willson556/OpenFFBoard-hardware/G27_InterfaceBoard/G27-Build-BOM.ods

Sheet: Summary
Description | Cost
Digikey (mostly PCB components) | $154.33
Large Components | $476.01
PCBs from JLCPCB | $96.12
Total | $726.46

Sheet: Digikey
Quantity Required | Quantity Ordered | Part Number | Manufacturer Part Number | Description | Board | Customer Reference | Backorder | Unit Price | Extended Price
1 | 2 | 732-4980-1-ND | 150060VS75000 | LED GREEN CLEAR 0603 SMD | TMC | 2 | 0 | 0.14 | $0.28
1 | 2 | 497-17239-1-ND | LDL1117S33R | IC REG LINEAR 3.3V 1.2A SOT223 | TMC | 10 | 0 | 0.48 | $0.96
12 | 15 | RMCF0603FT1K50CT-ND | RMCF0603FT1K50 | RES 1.5K OHM 1% 1/10W 0603 | TMC | 11 | 0 | 0.015 | $0.23
2 | 4 | 696-1184-1-ND | CSR2512C0R0015F | RES 0.0015 OHM 1% 3W 2512 | TMC | 12 | 0 | 0.65 | $2.60
17 | 20 | 1276-1000-1-ND | CL10B104KB8NNNC | CAP CER 0.1UF 50V X7R 0603 | TMC | 13 | 0 | 0.029 | $0.58
5 | 10 | 1276-6840-1-ND | CL21B104KCFNNNE | CAP CER 0.1UF 100V X7R 0805 | TMC | 14 | 0 | 0.054 | $0.54
3 | 10 | 720-VJ0603Y101KXAPW1BCCT-ND | VJ0603Y101KXAPW1BC | CAP CER 100PF 50V X7R 0603 | TMC | 15 | 0 | 0.074 | $0.74
10 | 16 | 311-10.0KHRCT-ND | RC0603FR-0710KL | RES SMD 10K OHM 1% 1/10W 0603 | TMC | 16 | 0 | 0.021 | $0.34
1 | 2 | 490-12780-1-ND | LQH43PN100M26L | FIXED IND 10UH 1.17A 176.4 MOHM | TMC | 17 | 0 | 0.38 | $0.76
6 | 10 | 732-8001-1-ND | 885012206083 | CAP CER 1000PF 50V X7R 0603 | TMC | 18 | 0 | 0.017 | $0.17
5 | 10 | 1276-1838-1-ND | CL31B105KCHNNNE | CAP CER 1UF 100V X7R 1206 | TMC | 19 | 0 | 0.146 | $1.46
8 | 10 | RMCF0603JT2R20CT-ND | RMCF0603JT2R20 | RES 2.2 OHM 5% 1/10W 0603 | TMC | 20 | 0 | 0.019 | $0.19
1 | 2 | 240-2755-1-ND | TYS8040221M-10 | FIXED IND 220UH 800MA 599 MOHM | TMC | 21 | 0 | 0.57 | $1.14
1 | 2 | P124028CT-ND | ERT-J1VR223G | MULTILAYER NTC CHIP THERMISTOR | TMC | 22 | 0 | 0.17 | $0.34
3 | 10 | RMCF0805FT294KCT-ND | RMCF0805FT294K | RES 294K OHM 1% 1/8W 0805 | TMC | 24 | 0 | 0.023 | $0.23
1 | 10 | CR0603-FX-3300ELFCT-ND | CR0603-FX-3300ELF | RES SMD 330 OHM 1% 1/10W 0603 | TMC | 25 | 0 | 0.015 | $0.15
4 | 10 | RMCF0805FT33K0CT-ND | RMCF0805FT33K0 | RES 33K OHM 1% 1/8W 0805 | TMC | 26 | 0 | 0.023 | $0.23
6 | 10 | RMCF0603JT4K70CT-ND | RMCF0603JT4K70 | RES 4.7K OHM 5% 1/10W 0603 | TMC | 27 | 0 | 0.013 | $0.13
5 | 10 | 1276-1065-1-ND | CL21A475KOFNNNE | CAP CER 4.7UF 16V X5R 0805 | TMC | 28 | 0 | 0.133 | $1.33
1 | 2 | 1727-7770-1-ND | PDZ5.6BGWJ | DIODE ZENER 5.6V 365MW SOD123 | TMC | 29 | 0 | 0.14 | $0.28
1 | 2 | 718-2142-1-ND | 593D476X0016D2TE3 | CAP TANT 47UF 20% 16V 2917 | TMC | 30 | 0 | 0.73 | $1.46
2 | 3 | PCE5185CT-ND | EEU-FS1K681B | CAP ALUM 680UF 20% 80V THRU HOLE | TMC | 32 | 0 | 1.88 | $5.64
3 | 10 | RMCF0805FT71K5CT-ND | RMCF0805FT71K5 | RES 71.5K OHM 1% 1/8W 0805 | TMC | 33 | 0 | 0.023 | $0.23
2 | 3 | AD8417BRMZ-ND | AD8417BRMZ | IC CURR SENSE 1 CIRCUIT 8MSOP | TMC | 34 | 0 | 2.92 | $8.76
1 | 2 | AP3012KTR-G1DICT-ND | AP3012KTR-G1 | IC REG BOOST ADJ 500MA SOT23-5 | TMC | 35 | 0 | 0.46 | $0.92
10 | 12 | BSC030N08NS5ATMA1CT-ND | BSC030N08NS5ATMA1 | MOSFET N-CH 80V 100A TDSON | TMC | 36 | 0 | 1.64 | $19.68
4 | 5 | 1727-3639-1-ND | BZX384-B13,115 | DIODE ZENER 13V 300MW SOD323 | TMC | 37 | 0 | 0.2 | $1.00
1 | 2 | XC2877CT-ND | ECS-3225MV-250-BN-TR | XTAL OSC XO 25.0000MHZ HCMOS SMD | TMC | 38 | 0 | 0.84 | $1.68
2 | 2 | ED2852-ND | OSTOQ040151 | TERM BLOCK HDR 4POS 90DEG 7.62MM | TMC | 39 | 0 | 1.16 | $2.32
6 | 7 | 1655-1931-1-ND | DSS110UTR | SCHOTTKY 100V SOD-123FL | TMC | 40 | 0 | 0.17 | $1.19
4 | 5 | LM5109BSD/NOPBCT-ND | LM5109BSD/NOPB | IC GATE DRVR HALF-BRIDGE 8WSON | TMC | 41 | 0 | 0.86 | $4.30
1 | 2 | 296-LM74700QDBVRQ1CT-ND | LM74700QDBVRQ1 | POWER MANAGEMENT | TMC | 42 | 0 | 1.84 | $3.68
3 | 4 | MBR120VLSFT1GOSCT-ND | MBR120VLSFT1G | DIODE SCHOTTKY 20V 1A SOD123FL | TMC | 43 | 0 | 0.44 | $1.76
1 | 2 | MAX5033BASA+-ND | MAX5033BASA+ | IC REG BUCK 5V 500MA 8SOIC | TMC | 44 | 0 | 3.02 | $6.04
1 | 2 | MCP1402T-E/OTCT-ND | MCP1402T-E/OT | IC GATE DRVR LOW-SIDE SOT23-5 | TMC | 45 | 0 | 0.62 | $1.24
2 | 3 | NC7NZ17K8XCT-ND | NC7NZ17K8X | IC BUFFER NON-INVERT 5.5V US8 | TMC | 46 | 0 | 0.52 | $1.56
1 | 2 | 1460-TMC4671-LA-ND | TMC4671-LA | SERVO CONTROLLER IC, QFN76 | TMC | 47 | 0 | 12.01 | $24.02
0 | 2 | MMSZ5266BT1GOSCT-ND | MMSZ5266BT1G | DIODE ZENER 68V 500MW SOD123 | TMC | 48 | 0 | 0.21 | $0.42
1 | 2 | ED10523-ND | 302-S161 | CONN HEADER VERT 16POS 2.54MM | TMC |  | 0 | 0.4 | $0.80
2 | 2 | ED2922-ND | OSTTJ040150 | TERM BLOCK PLUG 4POS STR 7.62MM | TMC |  | 0 | 2.47 | $4.94
2 | 2 | S9196-ND | SFH11-PBPC-D08-ST-BK | CONN HDR 16POS 0.1 GOLD PCB | OpenFFB Main |  | 0 | 1.04 | $2.08
2 | 2 | 1849-1002-ND | PR20205VBDN | CONN HEADER VERT 10POS 2.54MM | OpenFFB Main |  | 0 | 0.16 | $0.32
10 | 10 | S2012EC-11-ND | PREC011DAAN-RC | CONN HEADER VERT 22POS 2.54MM | OpenFFB Main |  | 0 | 0.393 | $3.93
2 | 2 | 609-5131-ND | 77311-818-09LF | CONN HEADER VERT 9POS 2.54MM | OpenFFB Main |  | 0 | 0.56 | $1.12
3 | 3 | 609-4616-1-ND | 10118193-0001LF | CONN RCPT USB2.0 MICRO B SMD R/A | OpenFFB Main |  | 0 | 0.45 | $1.35
1 | 1 | AE10968-ND | A-DS 09 A/KG-T2S | CONN D-SUB PLUG 9POS R/A SLDR | G27 Interface |  | 0 | 0.77 | $0.77
1 | 1 | 609-4419-ND | ID09S33E4GV00LF | CONN D-SUB RCPT 9POS R/A SLDR | G27 Interface |  | 0 | 1.17 | $1.17
2 | 2 | S7108-ND | PPPC052LFBN-RC | CONN HDR 10POS 0.1 GOLD PCB | G27 Interface |  | 0 | 0.71 | $1.42
2 | 2 | S7042-ND | PPPC091LFBN-RC | CONN HDR 9POS 0.1 GOLD PCB | G27 Interface |  | 0 | 0.67 | $1.34
2 | 2 | 609-1046-ND | 54602-908LF | CONN MOD JACK 8P8C R/A UNSHLD | G27 Interface |  | 0 | 0.65 | $1.30
6 | 6 | 732-12919-ND | 971100324 | BRASS SPACER STUD METRIC THREAD |  |  | 0 | 0.6 | $3.60
2 | 2 | S2112EC-11-ND | PREC011DBAN-M71RC | CONN HEADER R/A 22POS 2.54MM |  |  | 0 | 0.73 | $1.46
1 | 1 | S1311EC-40-ND | PRPC040SGAN-M71RC | CONN HEADER R/A 40POS 2.54MM |  |  | 0 | 0.97 | $0.97
14 | 14 | 36-24404-ND | 24404 | HEX STANDOFF M3 BRASS 12MM |  |  | 0 | 0.72 | $10.08
1 | 1 | H3CCH-2006M-ND | H3CCH-2006M | IDC CBL - HHKC20H/AE20M/HHKC20H | Debug IDC |  | 0 | 1.51 | $1.51
100 | 100 | H742-ND | MPMS 003 0005 PH | MACH SCREW PAN HEAD PHILLIPS M3 |  |  | 0 | 0.0653 | $6.53
1 | 1 | HS1004R7J-ND | HS100 4R7 J | RES CHAS MNT 4.7 OHM 5% 100W |  |  | 0 | 11.07 | $11.07
Total |  |  |  |  |  |  |  |  | $154.33

Sheet: Large Components
Description | Manufacturer | Part Number | Qty | Unit Price | Approx. Shipping | Ext Price | URL
Servo | Mige | 130ST-M10010 | 1 | $172.00 | $150.00 | $322.00 | https://www.alibaba.com/product-detail/small-Mige-130ST-M10010-ac-servo_60393398363.html
Servo Mount |  |  | 1 | $14.84 | $30.00 | $44.84 | https://www.aliexpress.com/item/4001079488981.html?spm=a2g0s.9042311.0.0.1e704c4dXADpNS
48V 9.5A Power Supply | Mean Well | HRPG-450-48 | 1 | $42.00 | $10.00 | $52.00 | https://www.ebay.com/itm/Mean-Well-HRPG-450-48-AC-DC-Power-Supply-Single-OUT-48V-9-5A-CNC-Router-Servo/183410848369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
Ethernet Coil Cable | Curlynet | 694536459151 | 1 | $16.99 | $0.00 | $16.99 | https://www.amazon.com/gp/product/B082PHSMM9/ref=ppx_yo_dt_b_asin_title_o07_s01?ie=UTF8&psc=1
JST PH-2.0 Connector Kit | CQRobot | CQRJST2MM-AUS | 1 | $12.99 | $0.00 | $12.99 | https://www.amazon.com/gp/product/B077LYP4T9/ref=ppx_yo_dt_b_asin_title_o00_s00?ie=UTF8&psc=1
USB Micro Cable | Monoprice | 105456 | 1 | $8.65 | $0.00 | $8.65 | https://www.amazon.com/Monoprice-1-5-Feet-Ferrite-Plated-105456/dp/B01AGKURSS?s=electronics
3” C-Clamp | Husky |  | 1 | $5.27 | $0.00 | $5.27 | https://www.homedepot.com/p/Husky-3-in-Drop-Forged-C-Clamp-97891/303693388
5/16-18 T-Nut (4 pack) | Everbilt | 802311 | 1 | $1.18 | $0.00 | $1.18 | https://www.homedepot.com/p/Everbilt-5-16-in-18-Zinc-Plated-Tee-Nut-4-Pack-802311/204274195
5/16-18 x 1 in Hex Bolt | Crown Bolt | 87096 | 4 | $0.21 | $0.00 | $0.84 | https://www.homedepot.com/p/Crown-Bolt-5-16-in-18-tpi-x-1-in-Zinc-Plated-Hex-Bolt-87096/204960781
5/16 Washers (10 pack) | Everbilt |  | 1 | $1.18 | $0.00 | $1.18 | https://www.homedepot.com/p/Everbilt-5-16-in-Zinc-Flat-Washer-10-Pack-802491/204276452
2ft x 2ft x 23/32in Sanded Plywood |  | 300950 | 1 | $10.07 | $0.00 | $10.07 | https://www.homedepot.com/p/Sanded-Plywood-Common-23-32-in-x-2-ft-x-2-ft-Actual-0-703-in-x-23-75-in-x-23-75-in-300950/202093835
Total |  |  |  |  |  | $476.01

Sheet: JLCPCB
Description | Cost
OpenFFB Board (assembled) | $31.18
TMC4671 Driver PCB | $23.70
G27 Interface Board (assembled) | $21.24
Approx. Shipping | $20.00
Total | $96.12
