willson556/OpenFFBoard-hardware/G27_InterfaceBoard/G27InterfaceBoard.brd

## EAGLE design G27_InterfaceBoard/G27InterfaceBoard.brd (2021-01-23)

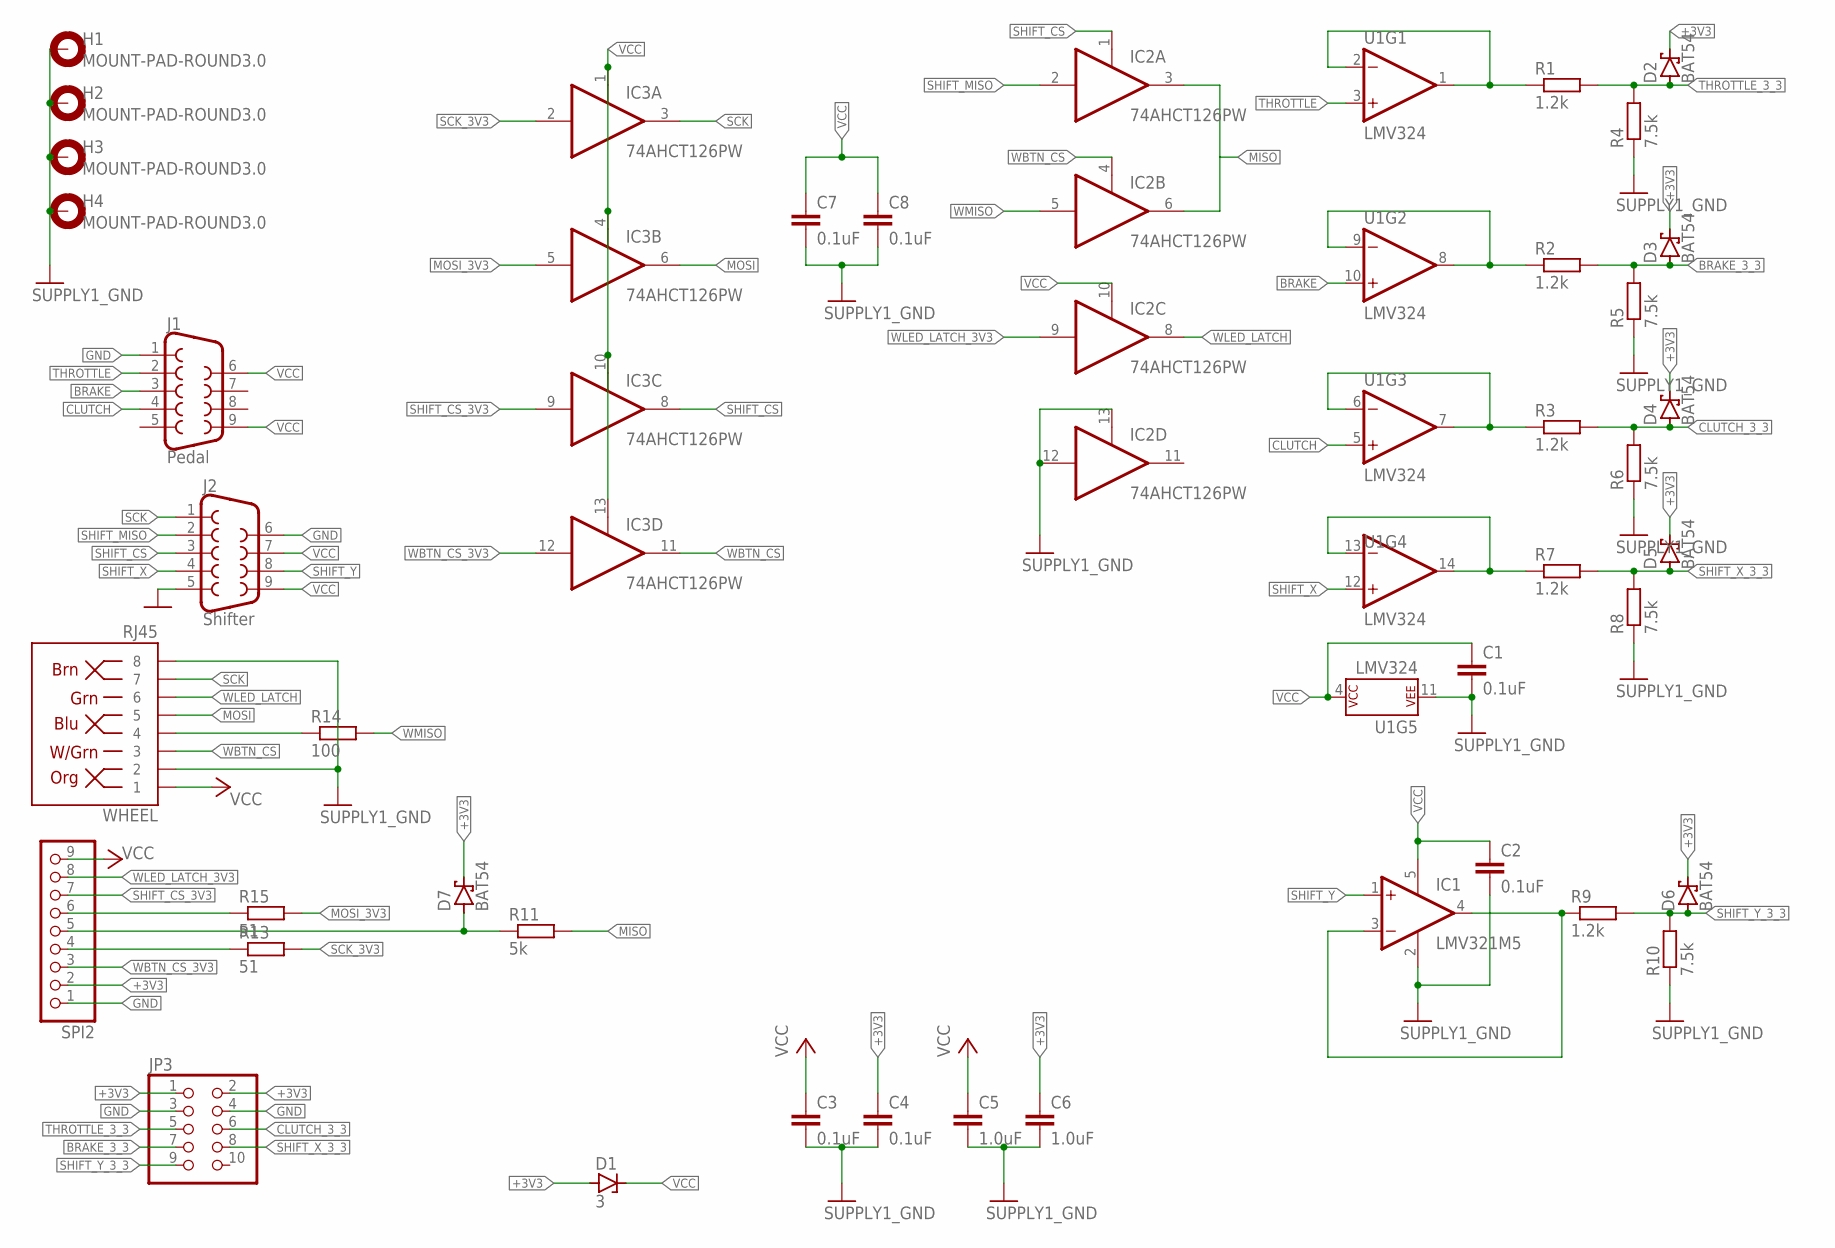
[picture p1: schematic G27InterfaceBoard.sch]

Parts:
C1, C2: 0.1uF; RESISTOR_C0603
C3, C4: 0.1uF; C0805
C5, C6: 1.0uF; C0805
C7, C8: 0.1uF; C0603
D1: 3; SOT23
D2, D3, D4, D5, D6, D7: BAT54; SOT23
H1, H2, H3, H4: MOUNT-PAD-ROUND3.0; 3,0-PAD
IC1: LMV321M5; SOT23-5
IC2, IC3: 74AHCT126PW; TSSOP14
J1: Pedal; DB9
J2: Shifter; DB9_MALE
JP3: PINHEAD_PINHD-2X5; PINHEAD_2X05
R1, R2, R3, R7, R9: 1.2k; R0603
R4, R5, R6, R8, R10: 7.5k; R0603
R11: 5k; R0603
R13, R15: 51; R0603
R14: 100; R0603
SPI2: PINHD-1X9; 1X09
U1: LMV324; SO14
WHEEL: RJ45; RJ45-8

Connections:
+3V3: C4.1, C6.1, D1.1 (A), D2.3 (C), D3.3 (C), D4.3 (C), D5.3 (C), D6.3 (C), D7.3 (C), JP3.1, JP3.2, SPI2.2
BRAKE: J1.3, U1.10 (+IN)
BRAKE_3_3: D3.1 (A), JP3.7, R2.2, R5.2
CLUTCH: J1.4, U1.5 (+IN)
CLUTCH_3_3: D4.1 (A), JP3.6, R3.2, R6.2
GND: C1.2, C2.2, C3.2, C4.2, C5.2, C6.2, C7.2, C8.2, H1.B3,0, H2.B3,0, H3.B3,0, H4.B3,0, IC1.2 (V-), IC2.7 (GND), IC2.12 (I), IC2.13 (OE), IC3.7 (GND), J1.1, J2.5, J2.6, JP3.3, JP3.4, R4.1, R5.1, R6.1, R8.1, R10.1, SPI2.1, U1.11 (P$V-), WHEEL.2, WHEEL.8
MISO: IC2.3 (O), IC2.6 (O), R11.2
MOSI: IC3.6 (O), WHEEL.5
MOSI_3V3: IC3.5 (I), R15.2
unnamed: R1.1, U1.1 (OUT), U1.2 (-IN)
unnamed: R7.1, U1.13 (-IN), U1.14 (OUT)
unnamed: IC1.3 (-IN), IC1.4 (OUT), R9.1
unnamed: D7.1 (A), R11.1, SPI2.5
unnamed: R2.1, U1.8 (OUT), U1.9 (-IN)
unnamed: R3.1, U1.6 (-IN), U1.7 (OUT)
unnamed: R13.1, SPI2.4
unnamed: R14.1, WHEEL.4
unnamed: R15.1, SPI2.6
SCK: IC3.3 (O), J2.1, WHEEL.7
SCK_3V3: IC3.2 (I), R13.2
SHIFT_CS: IC2.1 (OE), IC3.8 (O), J2.3
SHIFT_CS_3V3: IC3.9 (I), SPI2.7
SHIFT_MISO: IC2.2 (I), J2.2
SHIFT_X: J2.4, U1.12 (+IN)
SHIFT_X_3_3: D5.1 (A), JP3.8, R7.2, R8.2
SHIFT_Y: IC1.1 (+IN), J2.8
SHIFT_Y_3_3: D6.1 (A), JP3.9, R9.2, R10.2
THROTTLE: J1.2, U1.3 (+IN)
THROTTLE_3_3: D2.1 (A), JP3.5, R1.2, R4.2
VCC: C1.1, C2.1, C3.1, C5.1, C7.1, C8.1, D1.3 (C), IC1.5 (V+), IC2.10 (OE), IC2.14 (VCC), IC3.1 (OE), IC3.4 (OE), IC3.10 (OE), IC3.13 (OE), IC3.14 (VCC), J1.6, J1.9, J2.7, J2.9, SPI2.9, U1.4 (P$V+), WHEEL.1
WBTN_CS: IC2.4 (OE), IC3.11 (O), WHEEL.3
WBTN_CS_3V3: IC3.12 (I), SPI2.3
WLED_LATCH: IC2.8 (O), WHEEL.6
WLED_LATCH_3V3: IC2.9 (I), SPI2.8
WMISO: IC2.5 (I), R14.2

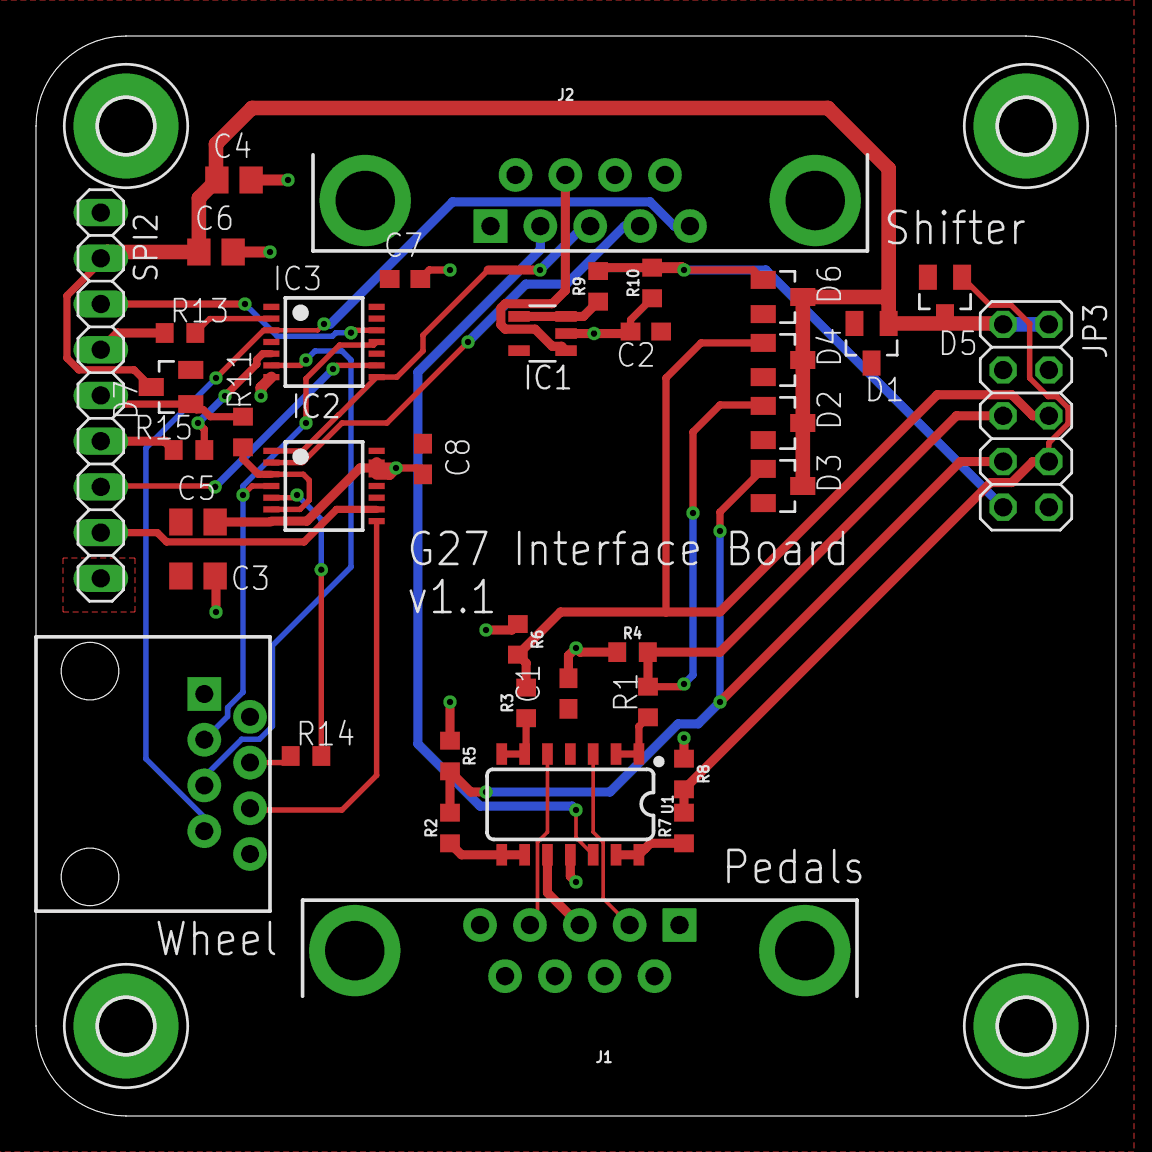
[picture p2: board G27InterfaceBoard.brd from above]

Board: 2 copper layers, 60.0 x 60.0 mm, 42 parts (0 on the bottom side), 35 nets.
