willson556/OpenFFBoard-hardware/(commit log)

2021-01-16 Started on G27 interface board.
    [G27InterfaceBoard.brd, G27InterfaceBoard.sch]
2021-01-16 Modfications to board based on testing.
    [G27InterfaceBoard.brd, G27InterfaceBoard.sch]
2021-01-16 Add some termination resistors to the SPI lines.
    A breadboarded version of this is now working with the G27 shifter
    and wheel simulataneously. LED control is not yet tested.
    [G27InterfaceBoard.brd, G27InterfaceBoard.sch]
2021-01-16 G27InterfaceBoard v1.0 as ordered.
    [G27InterfaceBoard.brd, G27InterfaceBoard.sch, G27InterfaceBoard_top_bom.csv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]
2021-01-17 Start of documentation.
    [G27-Build-BOM.ods]
2021-01-17 Add large components to BOM.
    Also, document more required tools.
    [G27-Build-BOM.ods]
2021-01-17 Add PCB costs to BOM.
    [G27-Build-BOM.ods]
2021-01-21 Add missing trace for wheel SCK.
    [G27InterfaceBoard.brd, G27InterfaceBoard.sch]
2021-01-21 Bump board revision.
    [G27InterfaceBoard.brd]
2021-01-23 Closer on G27 Interface v1.1:
    Use buffer to boost 3.3V signals from STM32 to 5V logic to buy
    better noise margin.
    [G27InterfaceBoard.brd, G27InterfaceBoard.sch]
2021-01-23 Add additional filter caps.
    [G27InterfaceBoard.brd, G27InterfaceBoard.sch]
2021-01-23 Add voltage clamps to signals that could go above 3.3V.
    [G27InterfaceBoard.brd, G27InterfaceBoard.sch]
2021-01-23 Add better 5V, 3.3V, and GND connections.
    [G27InterfaceBoard.brd, G27InterfaceBoard.sch]
2021-01-23 Connect shift power LED to ground.
    [G27InterfaceBoard.brd, G27InterfaceBoard.sch]
2021-01-23 Minor silkscreen cleanup.
    [G27InterfaceBoard.brd]
2021-01-23 G27InterfaceBoard v1.1 as ordered.
    [G27InterfaceBoard_top_bom.csv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]
